mike-crius/Crius-PowerSupply-PCB/power_supply_v1.01_PCB-BOTTOM.png

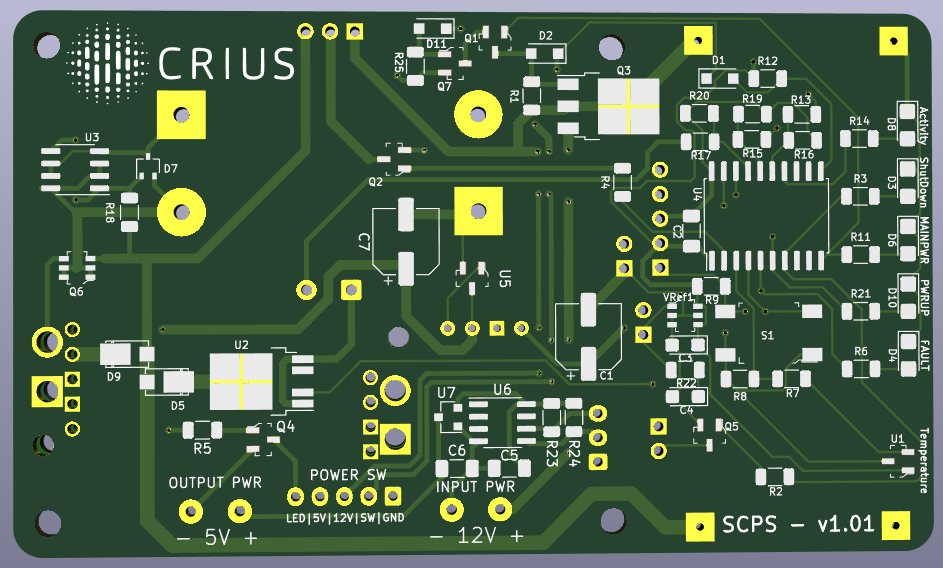
power_supply_v1.01_PCB-BOTTOM.png
