mike-crius/Crius-PowerSupply-PCB/power_supply_v1.01_PCB-TOP.png

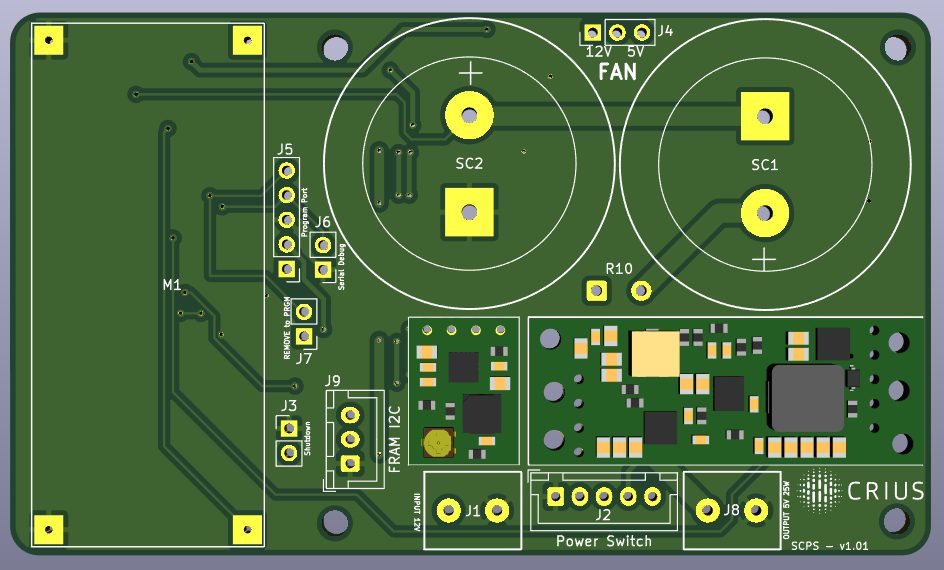
power_supply_v1.01_PCB-TOP.png
