mike-crius/Crius-PowerSupply-PCB/power_supply_v1.02_schematic.pdf

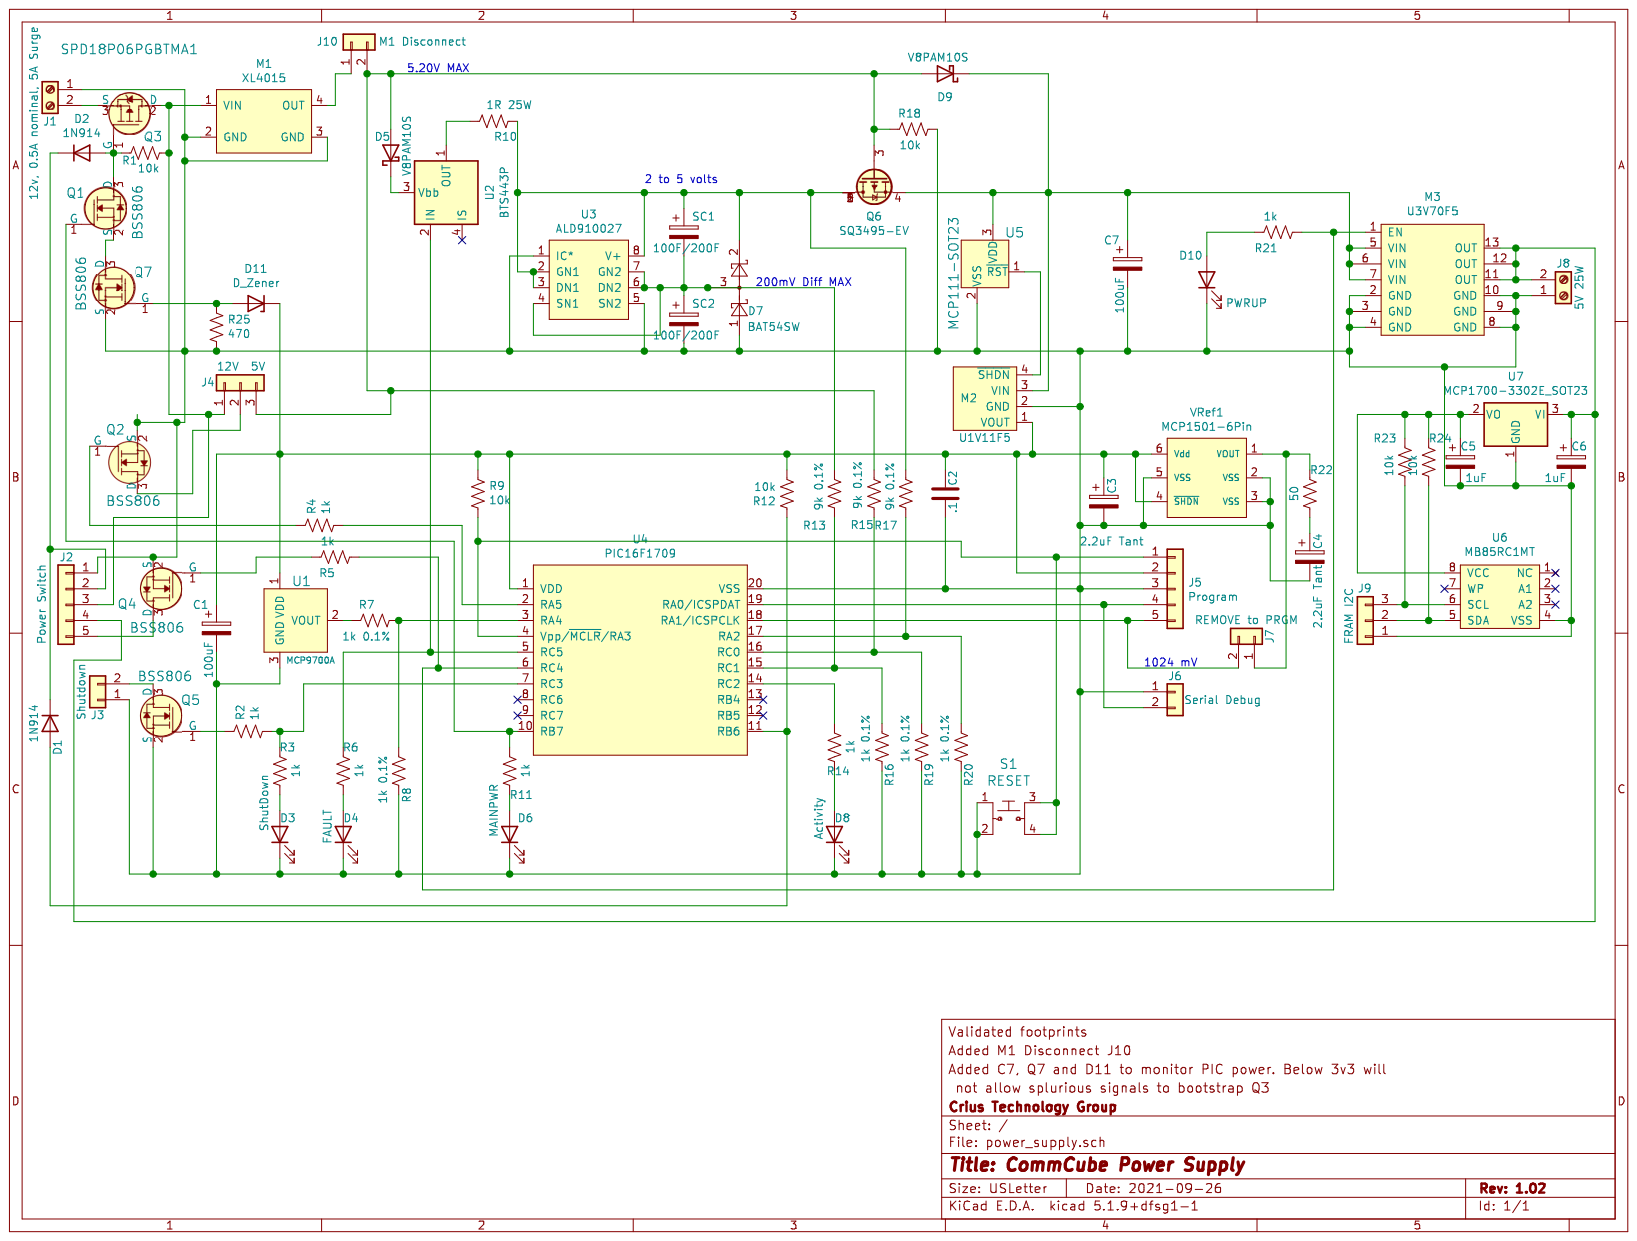
[picture p3: page 1]
