mike-crius/Crius-PowerSupply-PCB/power_supply_v1.01_PCB.pdf

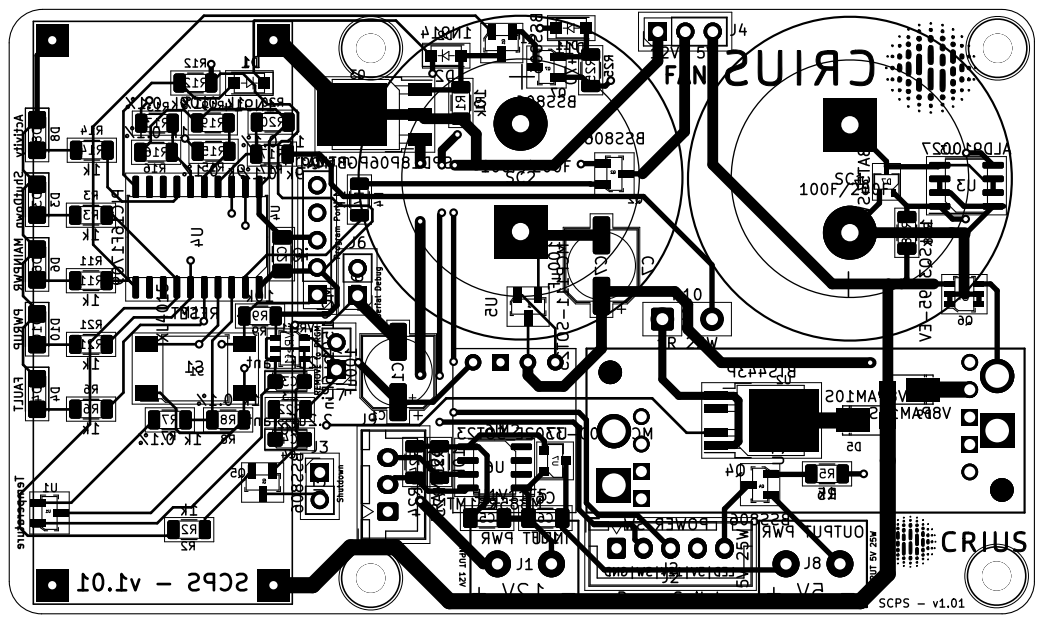
[picture p4: page 1]
