mike-crius/Crius-PowerSupply-PCB/power_supply_v1.01_schematic.pdf

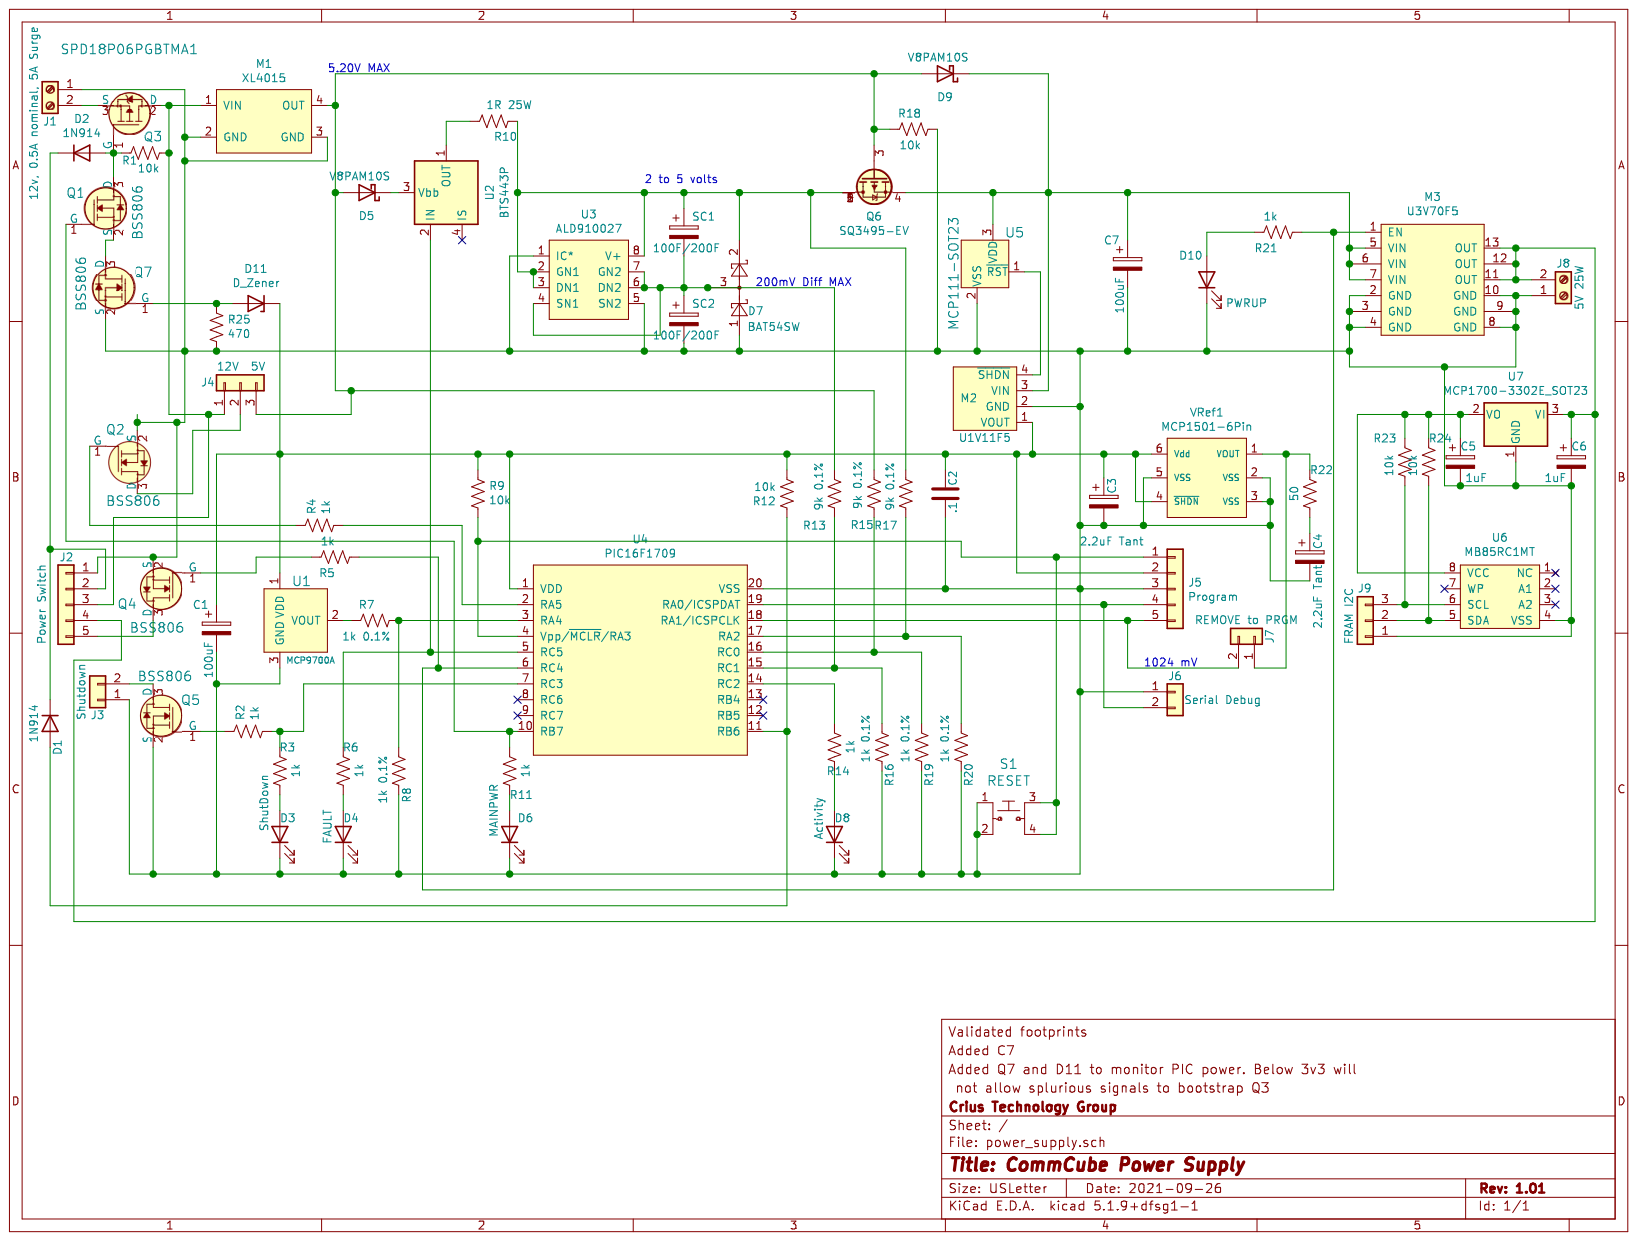
[picture p5: page 1]
