mike-crius/Crius-PowerSupply-PCB/power_supply_1.03.kicad_pcb

## KiCad design power_supply_1.03.kicad_pcb (2021-11-21)

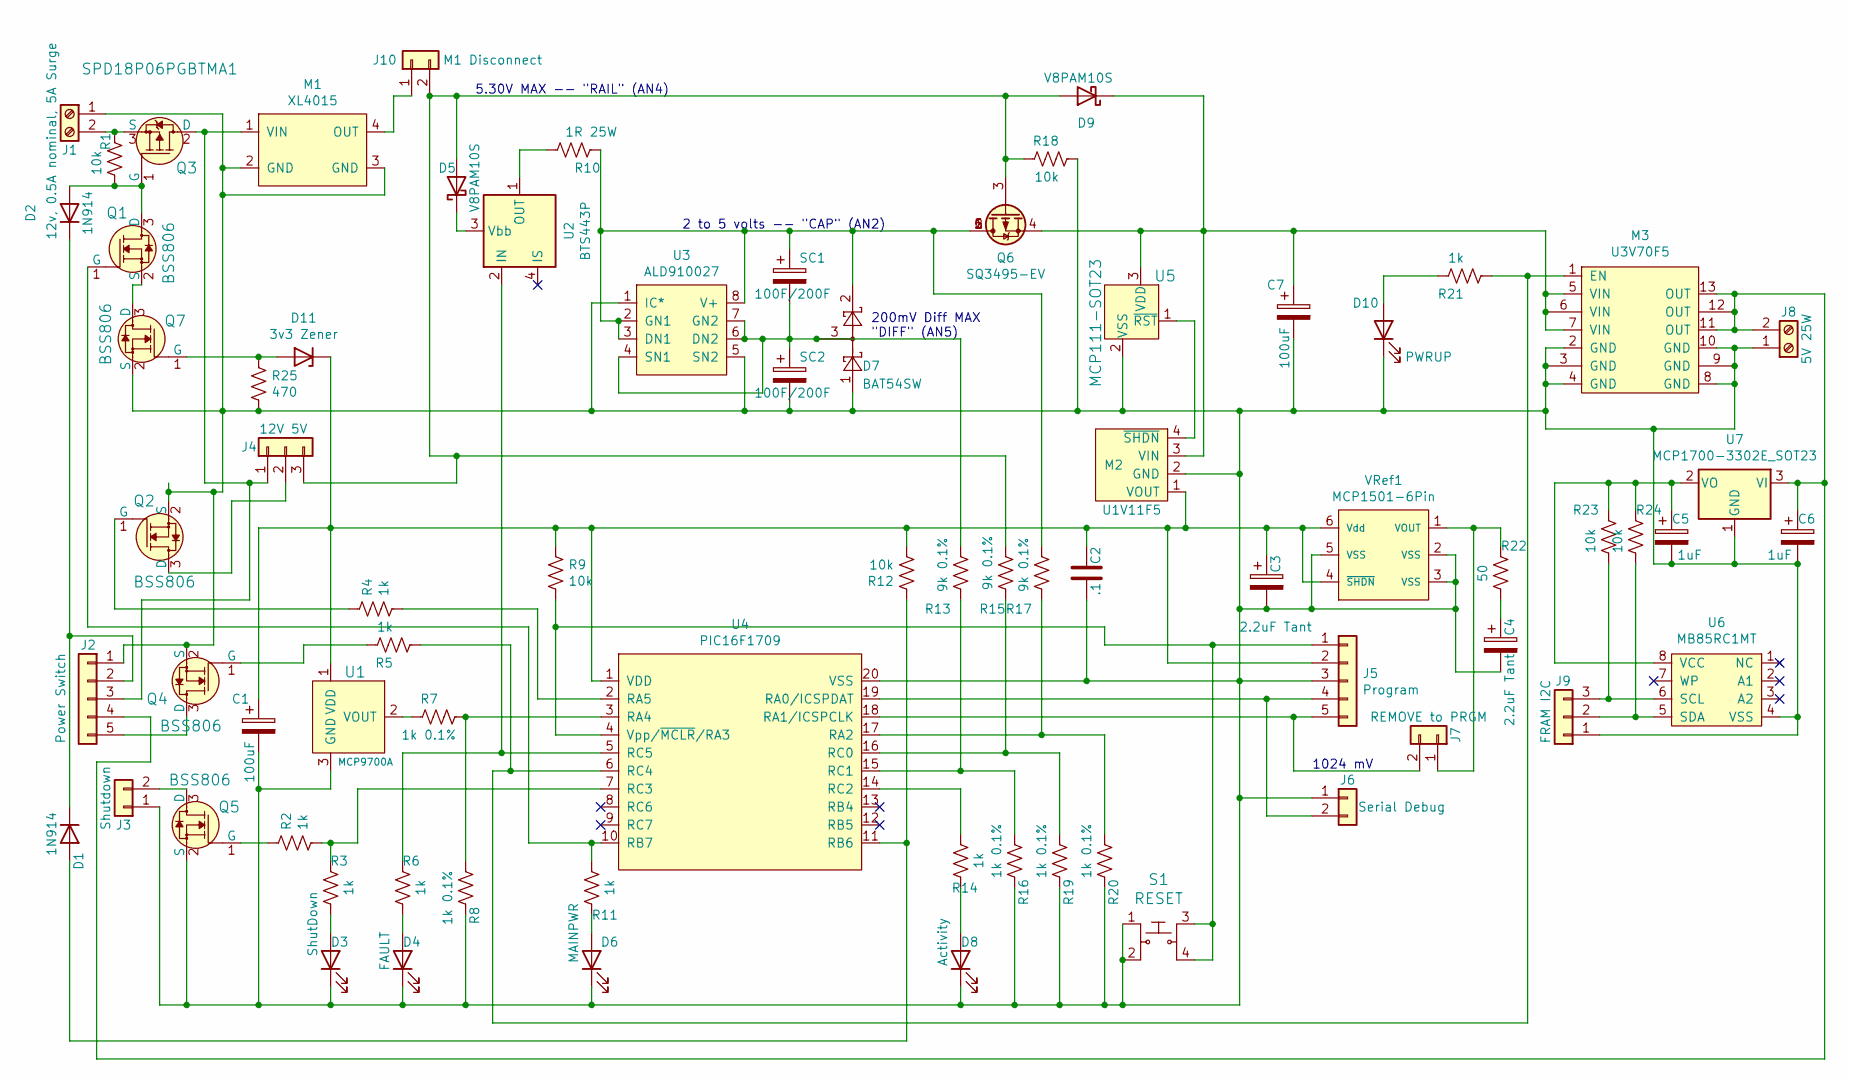
[picture p6: schematic power_supply_1.03.sch, CommCube Power Supply]

Parts:
C1, C7: 100uF; CP_Elec_6.3x5.2; Part# 661-EMVY160ADA101MF5
C2: .1; C_1206_3216Metric_Pad1.33x1.80mm_HandSolder; Part# 77-VJ1206Y104MXJPBC
C3, C4: 2.2uF Tant; CP_EIA-3216-18_Kemet-A; Part# 80-T491A225K010
C5, C6: 1uF; C_1206_3216Metric_Pad1.33x1.80mm_HandSolder; Part# 80-C1206C105K3RAUTO
D1, D2: 1N914; D_SOD-123F; Part# 821-1N914BWRHG
D3: ShutDown; D_1206_3216Metric_Castellated; Part# 645-598-8240-107F
D4: FAULT; D_1206_3216Metric_Castellated; Part# 645-598-8220-107F
D5, D9: V8PAM10S; DO-221BC; Part# 78-V8PAM10SHM3/H
D6: MAINPWR; D_1206_3216Metric_Castellated; Part# 645-598-8270-107F
D7: BAT54SW; SOT-323_SC-70; Part# 771-BAT54SWF
D8: Activity; D_1206_3216Metric_Castellated; Part# 645-598-8291-107F
D10: PWRUP; D_1206_3216Metric_Castellated; Part# 645-598-8270-107F
D11: 3v3 Zener; D_SOD-123F; Part# 771-NZH3V3A-115
J1: 12v, 0.5A nominal, 5A Surge; Screw_Terminal_2Pin
J2: Power Switch; JST_XH_B5B-XH-A_1x05_P2.50mm_Vertical
J3: Shutdown; PinHeader_1x02_P2.54mm_Vertical
J4: 12V 5V; JST_XH_B3B-XH-A_1x03_P2.50mm_Vertical
J5: Program; PinHeader_1x05_P2.54mm_Vertical
J6: Serial Debug; PinHeader_1x02_P2.54mm_Vertical
J7: REMOVE to PRGM; PinHeader_1x02_P2.54mm_Vertical
J8: 5V 25W; Screw_Terminal_2Pin
J9: FRAM I2C; JST_XH_B3B-XH-A_1x03_P2.50mm_Vertical
J10: M1 Disconnect; PinHeader_1x02_P2.54mm_Vertical
M1: XL4015
M2: U1V11F5; U1V11Fx; Part# 2562
M3: U3V70F5; Part# 2891
Q1, Q2, Q4, Q7: BSS806; SOT-23-3; MPN BSS138; Digi-Key_PN BSS138CT-ND
Q3: SPD18P06PGBTMA1; TO-252-3_TabPin2; MPN IRF9540NPBF; Digi-Key_PN IRF9540NPBF-ND
Q5: BSS806; SOT-23-3; Part# 726-BSS806NEH6327XTS
Q6: SQ3495-EV; SOT-23-6; Part# 78-SQ3495EV-T1_GE3
R1, R9, R12, R18, R23, R24: 10k; R_1206_3216Metric; Part# 603-RT1206FRD0710KL
R2, R3, R4, R5, R6, R11, R14, R21: 1k; R_1206_3216Metric; Part# 603-RT1206FRD071KL
R7, R8, R16, R19, R20: 1k 0.1%; R_1206_3216Metric; Part# 603-RT1206BRD071KL
R10: 1R 25W; SolderWire-0.5sqmm_1x02_P4.6mm_D0.9mm_OD2.1mm; Part# 71-RH0251R000FE02
R13, R15, R17: 9k 0.1%; R_1206_3216Metric; Part# 603-RT1206BRD079KL
R22: 50; R_1206_3216Metric; Part# 660-RN732BTTD50R0B25
R25: 470; R_1206_3216Metric; Part# 603-RT1206FRE07470RL
S1: RESET; Panasonic 6x6mm EVQ-7Q201W; MPN 1825910-6; Digi-Key_PN 450-1650-ND
SC1, SC2: 100F/200F; SCC-22-30mm; Part# 581-SCCW45B107SSB / 581-SCCW45B207SSB
U1: MCP9700A; SOT-23-3; Part# 579-MCP9700AT-E/TT
U2: BTS443P; TO-252-4; Part# 726-BTS443P
U3: ALD910027; SOIC-8_3.9x4.9mm_P1.27mm; Part# 585-ALD910027SAL
U4: PIC16F1709; SOIC-20W_7.5x12.8mm_P1.27mm; Part# 579-PIC16F1709T-I/SO
U5: MCP111-SOT23; SOT-23-3; MPN MCP130T-300I/TT; Digi-Key_PN MCP130T-300I/TTCT-ND
U6: MB85RC1MT; SOIC-8_3.9x4.9mm_P1.27mm; Part# 249-85C1MTPNFGJNERE1
U7: MCP1700-3302E_SOT23; SOT-23; Part# 579-MCP1700T3302E/TT
VRef1: MCP1501-6Pin; SOT-23-6; Part# 579-MCP1501T-10E/CHY

Connections:
unnamed: C1.1, C2.2, C3.1, D11.1 (K), J5.2, M2.1 (VOUT), R9.2, R12.1, U1.1 (VDD), U4.1 (VDD), VRef1.4 (~SHDN), VRef1.6 (Vdd)
unnamed: C1.2, C2.1, C3.2, C4.2, C5.2, C6.2, C7.2, D3.1 (K), D4.1 (K), D6.1 (K), D7.1, D8.1 (K), D10.1 (K), J1.1, J2.1, J3.1, J5.3, J6.1, J8.1, J9.1, M1.2 (GND), M1.3 (GND), M2.2 (GND), M3.2 (GND), M3.3 (GND), M3.4 (GND), M3.8 (GND), M3.9 (GND), M3.10 (GND), Q2.2 (S), Q4.2 (S), Q5.2 (S), Q7.2 (S), R8.2, R16.1, R18.1, R19.1, R20.1, R25.1, S1.1, S1.2, SC2.1, U1.3 (GND), U3.1 (IC*), U3.5 (SN2), U4.20 (VSS), U5.2 (VSS), U6.4 (VSS), U7.1 (GND), VRef1.2 (VSS), VRef1.3 (VSS), VRef1.5 (VSS)
unnamed: C4.1, R22.2
unnamed: C5.1, R23.1, R24.1, U6.8 (VCC), U7.2 (VO)
unnamed: C6.1, J2.4, J8.2, M3.11 (OUT), M3.12 (OUT), M3.13 (OUT), U7.3 (VI)
unnamed: C7.1, D9.1 (K), M2.3 (VIN), M3.5 (VIN), M3.6 (VIN), M3.7 (VIN), Q6.4 (S), U5.3 (VDD)
unnamed: D1.1 (K), D2.1 (K), J2.2
unnamed: D1.2 (A), R12.2, U4.11 (RB6)
unnamed: D2.2 (A), Q1.3 (D), Q3.1 (G), R1.2
unnamed: D3.2 (A), R3.2
unnamed: D4.2 (A), R6.2
unnamed: D5.1 (K), U2.3 (Vbb)
unnamed: D5.2 (A), D9.2 (A), J4.3, J10.2, Q6.3 (G), R15.2, R18.2
unnamed: D6.2 (A), R11.2
unnamed: D7.2, Q6.1 (D), Q6.2 (D), Q6.5 (D), Q6.6 (D), R10.2, R17.1, SC1.2, U3.2 (GN1), U3.3 (DN1), U3.8 (V+)
unnamed: D7.3, R13.1, SC1.1, SC2.2, U3.4 (SN1), U3.6 (DN2), U3.7 (GN2)
unnamed: D8.2 (A), R14.2
unnamed: D10.2 (A), R21.2
unnamed: D11.2 (A), Q7.1 (G), R25.2
unnamed: J1.2, Q3.3 (S), R1.1
unnamed: J2.3, J4.1, M1.1 (VIN), Q3.2 (D)
unnamed: J2.5, Q4.3 (D)
unnamed: J3.2, Q5.3 (D)
unnamed: J4.2, Q2.3 (D)
unnamed: J5.1, R9.1, S1.3, S1.4, U4.4 (Vpp/~MCLR~/RA3)
unnamed: J5.4, J6.2, U4.19 (RA0/ICSPDAT)
unnamed: J5.5, J7.2, U4.18 (RA1/ICSPCLK)
unnamed: J7.1, R22.1, VRef1.1 (VOUT)
unnamed: J9.2, R24.2, U6.5 (SDA)
unnamed: J9.3, R23.2, U6.6 (SCL)
unnamed: J10.1, M1.4 (OUT)
unnamed: M2.4 (~SHDN), U5.1 (~RST)
unnamed: M3.1 (EN), R5.1, R21.1, U4.6 (RC4)
unnamed: Q1.1 (G), R11.1, U4.10 (RB7)
unnamed: Q1.2 (S), Q7.3 (D)
unnamed: Q2.1 (G), R4.2
unnamed: Q4.1 (G), R5.2
unnamed: Q5.1 (G), R2.2
unnamed: R2.1, R3.1, U4.7 (RC3)
unnamed: R4.1, U4.2 (RA5)
unnamed: R6.1, U2.2 (IN), U4.5 (RC5)
unnamed: R7.1, R8.1, U4.3 (RA4)
unnamed: R7.2, U1.2 (VOUT)
unnamed: R10.1, U2.1 (OUT), U2.5 (OUT)
unnamed: R13.2, R16.2, U4.15 (RC1)
unnamed: R14.1, U4.14 (RC2)
unnamed: R15.1, R19.2, U4.16 (RC0)
unnamed: R17.2, R20.2, U4.17 (RA2)

Notes on the sheet:
2 to 5 volts -- "CAP" (AN2)
1024 mV
5.30V MAX -- "RAIL" (AN4)
200mV Diff MAX "DIFF" (AN5)

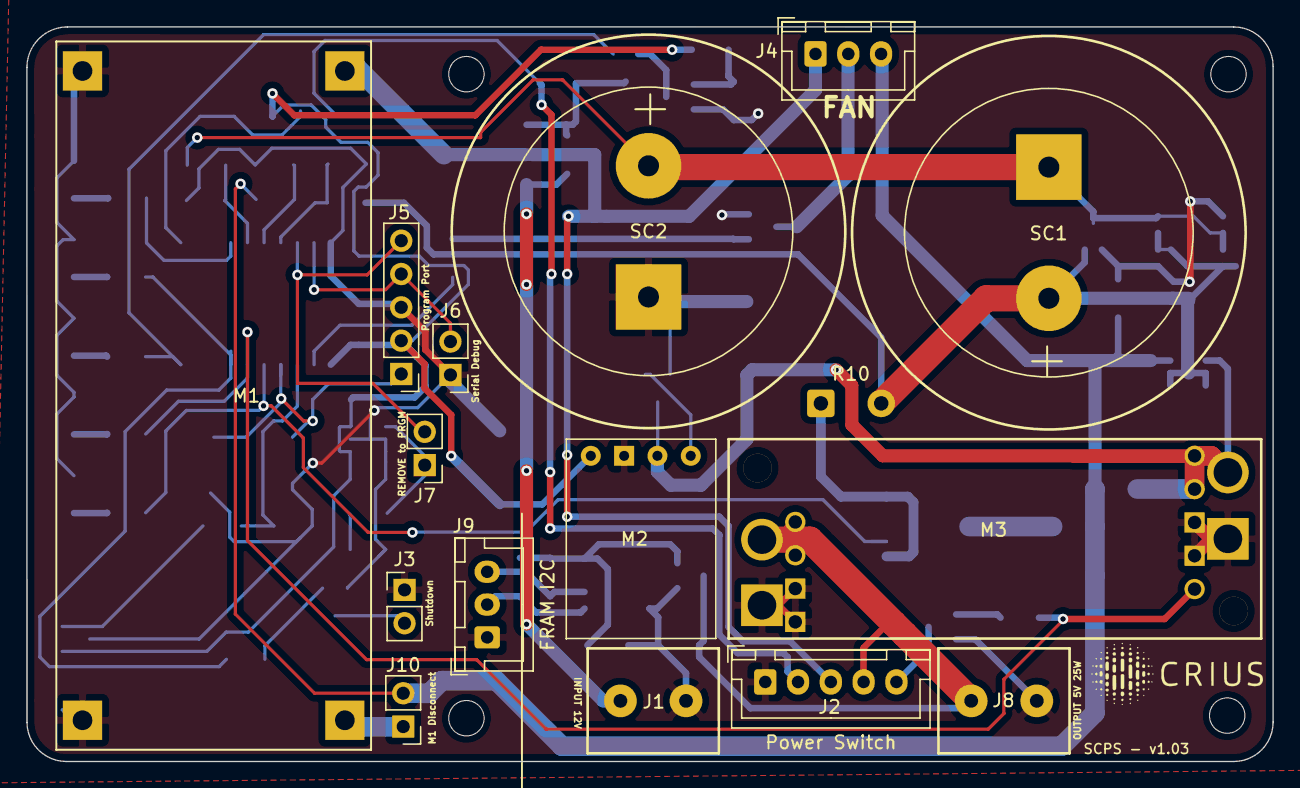
[picture p7: board power_supply_1.03.kicad_pcb from above]

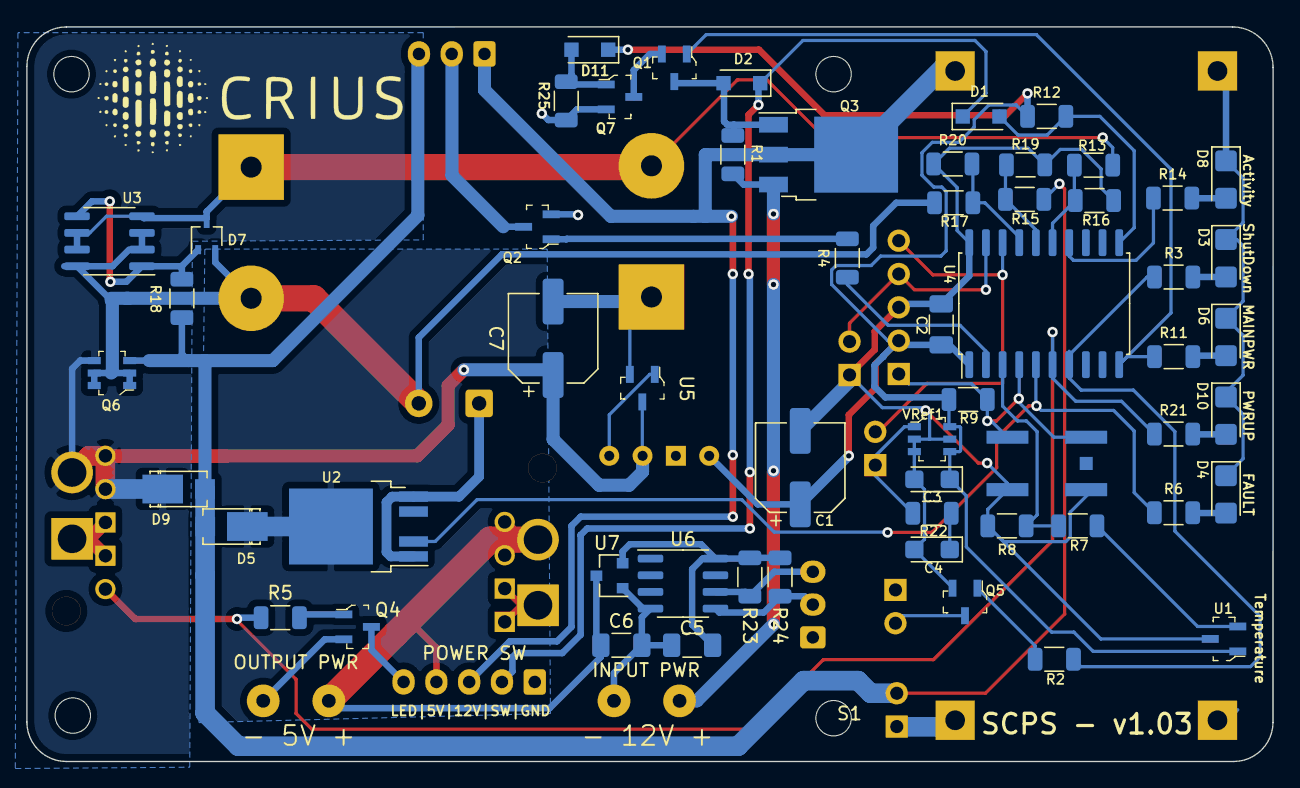
[picture p8: board power_supply_1.03.kicad_pcb from below]

Board: 2 copper layers, 95.0 x 56.0 mm, 74 parts (58 on the bottom side), 48 nets.
