mike-crius/Crius-PowerSupply-PCB/(commit log)

2021-09-26 Initial v0.31
    [power_supply.kicad_pcb, power_supply.sch]
2021-10-18 Version 0.35 includes updates for new parts and field updates for PCB
    [power_supply.sch]
2021-10-23 Version 0.36 circuit part changes, completed initial parts information and BOM
    [BOM.csv, power_supply.sch]
2021-11-07 Version 1.0 includes fixes/changes and FRAM support
    [power_supply.kicad_pcb, power_supply.sch]
2021-11-10 Version 1.01 - Includes fixes, footprint validation, gerbers, screenshots, documentation
    [BOM.csv, power_supply.kicad_pcb, power_supply.sch]
2021-11-11 Version 1.02 adds M1 disconnect for initial adjustment of M1
    [power_supply_1.02.kicad_pcb, power_supply_1.02.sch]
2021-11-21 Version 1.03 fixes M1, J4, SW footprints. R1 schematic error fixed. Heat sink copper area for U2, D5, D9
    [power_supply_1.03.kicad_pcb, power_supply_1.03.sch]
2022-01-09 LiPo Version 0.1 Initial schematic for LiPo version
    [power_supply_LiPo.sch]
